andreysenes/synth/voz-9/refs/faceplate-silk-reference.png

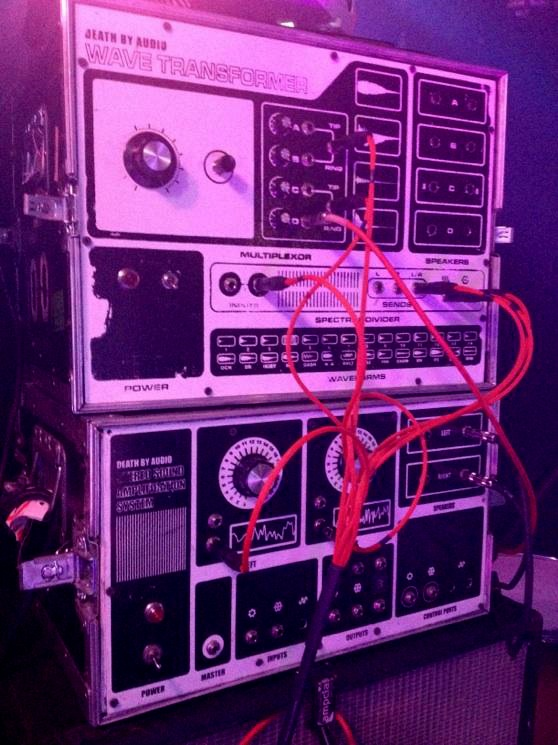
voz-9/refs/faceplate-silk-reference.png
