andreysenes/synth/voz-9/refs/README.md

# Referências mecânicas e de interface

| Arquivo | Uso |
| --- | --- |
| `faceplate-silk-reference.png` | Referência visual de densidade, blocos e silkscreen alto contraste em faceplate de alumínio (DEC-036). Não copiar arte, tipografia ou layout de terceiros. |

O acabamento base do alumínio (anodizado, escovado, etc.) permanece adiado em DEC-034/MEC-016. A posição fina dos controles no faceplate permanece adiada em DEC-037/MEC-018.
