andreysenes/synth/voz-9/kicad/01-fonte.kicad_sch

## KiCad design voz-9/kicad/01-fonte.kicad_sch (2026-09-28)

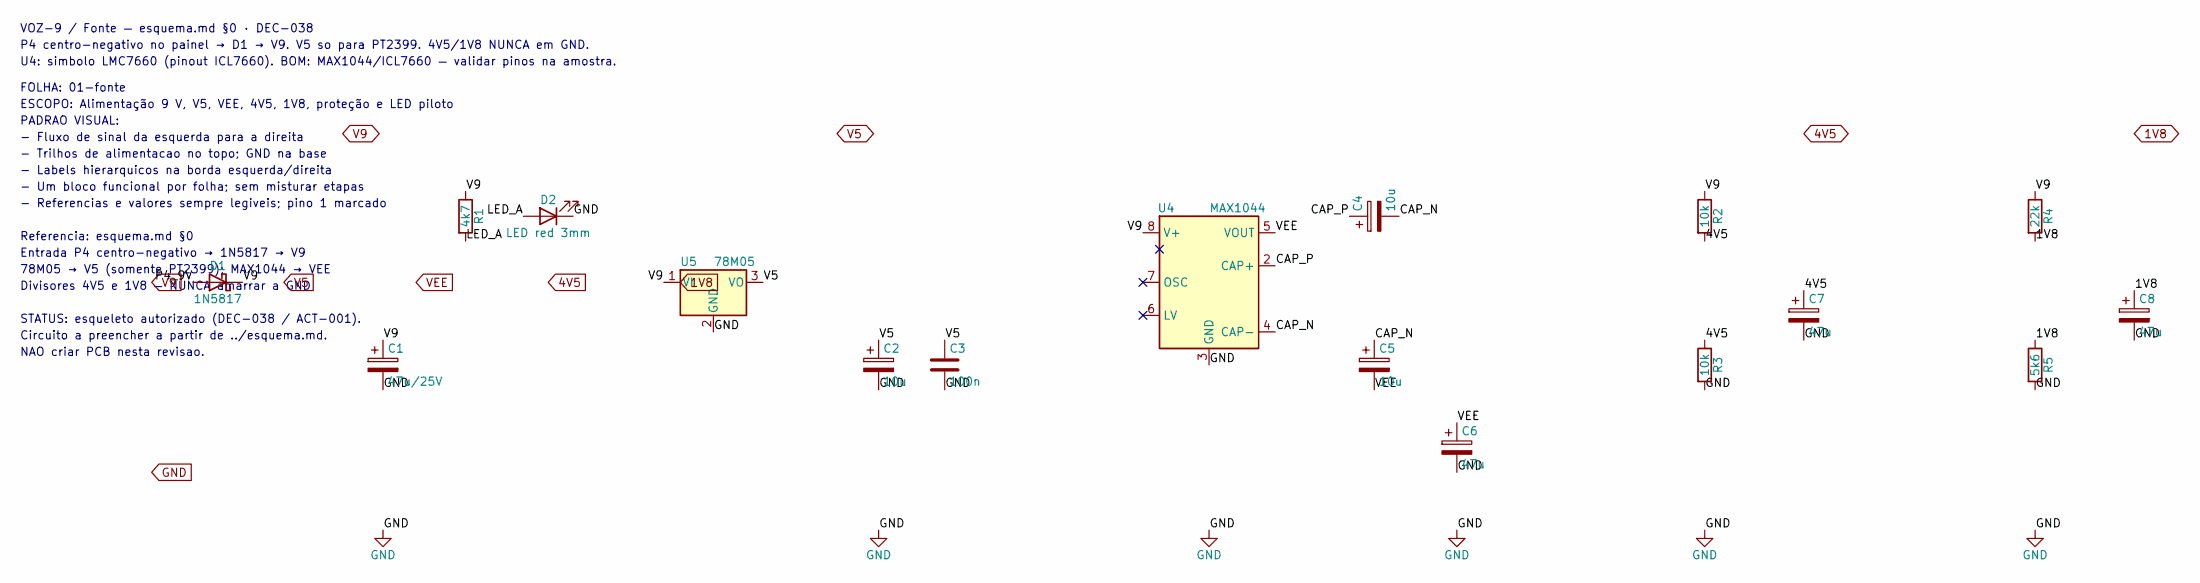
[picture p2: schematic 01-fonte.kicad_sch]

Parts:
C1: 47u/25V
C2, C4, C5: 10u
C3: 100n
C6, C7, C8: 47u
D1: 1N5817; D_DO-41_SOD81_P10.16mm_Horizontal
D2: LED red 3mm
R1: 4k7
R2, R3: 10k
R4: 22k
R5: 5k6
U4: MAX1044
U5: 78M05; TO-220-3_Vertical

Connections:
1V8: C8.1, R4.2, R5.1
4V5: C7.1, R2.2, R3.1
CAP_N: C4.2, C5.1, U4.4 (CAP-)
CAP_P: C4.1, U4.2 (CAP+)
GND: C1.2, C2.2, C3.2, C6.2, C7.2, C8.2, D2.1 (K), R3.2, R5.2, U4.3 (GND), U5.2 (GND)
LED_A: D2.2 (A), R1.2
P4_9V: D1.2 (A)
V5: C2.1, C3.1, U5.3 (VO)
V9: C1.1, D1.1 (K), R1.1, R2.1, R4.1, U4.8 (V+), U5.1 (VI)
VEE: C5.2, C6.1, U4.5 (VOUT)

Notes on the sheet:
FOLHA: 01-fonte
ESCOPO: Alimentação 9 V, V5, VEE, 4V5, 1V8, proteção e LED piloto
PADRAO VISUAL:
- Fluxo de sinal da esquerda para a direita
- Trilhos de alimentacao no topo; GND na base
- Labels hierarquicos na borda esquerda/direita
- Um bloco funcional por folha; sem misturar etapas
- Referencias e valores sempre legiveis; pino 1 marcado
Referencia: esquema.md §0
Entrada P4 centro-negativo → 1N5817 → V9
78M05 → V5 (somente PT2399); MAX1044 → VEE
Divisores 4V5 e 1V8 — NUNCA amarrar a GND
STATUS: esqueleto autorizado (DEC-038 / ACT-001).
Circuito a preencher a partir de ../esquema.md.
NAO criar PCB nesta revisao.
VOZ-9 / Fonte — esquema.md §0 · DEC-038
P4 centro-negativo no painel → D1 → V9. V5 so para PT2399. 4V5/1V8 NUNCA em GND.
U4: simbolo LMC7660 (pinout ICL7660). BOM: MAX1044/ICL7660 — validar pinos na amostra.
