andreysenes/synth/(commit log)

2026-09-13 Publish VOZ-9 synth docs, PCB artwork, and simulator.
    [jlcpcb-bom.csv]
2026-09-28 docs: define KiCad layout agent workflow
2026-09-28 docs: define KiCad PCB requirements baseline
2026-09-28 docs: record approved PCB product decisions
2026-09-28 docs: derive PCB requirements from digital simulation
2026-09-28 docs: add full panel LED indicators
2026-09-28 docs: select low-current 3mm panel LEDs
2026-09-28 docs: set panel LED current target
2026-09-28 docs: isolate switch LED contacts
2026-09-28 docs: choose discrete LED drivers
2026-09-28 docs: calibrate zero VU at zero dBV
2026-09-28 docs: derive clip LED threshold from output
2026-09-28 docs: make gate LED follow envelope
2026-09-28 docs: resize faceplate and internal PCB
2026-09-28 docs: set provisional box internal height to 60 mm
    Record DEC-029 and approve MEC-012 with a 60 mm clear height
    budget pending VU sample measurement.
2026-09-28 docs: set wooden box wall thickness and external envelope
    Record DEC-030 and MEC-013: 15–18 mm walls with provisional
    336×336 mm outer plan around the 300×300 faceplate.
2026-09-28 docs: sync box envelope notes across mechanical docs
    Align README, playbook, pcb, BOM and JLCPCB notes with DEC-030.
2026-09-28 docs: clarify box size wording in agent prompt
    Separate outer plan (~336×336) from internal height (60 mm).
2026-09-28 docs: define aluminum faceplate thickness
    Record DEC-031 and MEC-014: aluminum faceplate 1.5–2.0 mm
    with provisional nominal 2.00 mm.
2026-09-28 docs: keep P4 and combo jacks on the faceplate
    Record DEC-032 and IF-015: power and combo I/O mount on the
    aluminum top panel, not on a rear panel.
2026-09-28 docs: bond faceplate ground via nuts and dedicated wire
    Record DEC-033 with conductive jack nuts plus an insulated
    chassis bonding wire to the BASE GND star.
2026-09-28 docs: place harness headers on bottom edge by signal flow
    Record DEC-035, MEC-004 and PLC-012: J1–J11 along the PCB
    bottom edge, ordered by signal logic instead of the legacy left column.
2026-09-28 docs: define direct aluminum faceplate silkscreen
    Record DEC-036/MEC-017 and store the visual density reference
    image without copying third-party artwork.
2026-09-28 docs: defer faceplate control placement with finish work
    Record DEC-037/MEC-018 so VU/LED/control coordinates wait with
    panel finishing and do not block the BASE electrical baseline.
2026-09-28 feat: start hierarchical KiCad schematic project without PCB
    Authorize DEC-038/ACT-001 with one block per sheet (fonte, osc,
    noise, mix-eq, shape, vcf, vca, lfo, echo, saida, indicadores,
    conectores) and shared visual conventions. No .kicad_pcb yet.
    [01-fonte.kicad_sch, 02-osc.kicad_sch, 03-noise.kicad_sch, 04-mix-eq.kicad_sch, 05-shape.kicad_sch, 06-vcf.kicad_sch, 07-vca.kicad_sch, 08-lfo.kicad_sch]
2026-09-28 feat: install Konnect and capture power sheet
    Add Konnect MCP config/client for realtime schematic edits, document
    KiCad 10 realtime viewing, and fill 01-fonte from esquema.md §0 with
    validated connectivity (no PCB).
    [01-fonte.kicad_sch]
2026-09-28 docs: note fonte sheet progress and ignore Konnect backups
    Ignore local KiCad backup zips and record ACT-001 fonte progress.
2026-09-29 docs: point Konnect and wrappers at KiCad 10.0.6
    Install KiCad 10 AppImage lite on the VM; update konnect.toml and
    KONNECT.md. Large AppImage stays local/gitignored.
2026-09-29 chore: gitignore KiCad 10 AppImage extract tree
